MissCrispenCakes/CutiePI/README.md

# CutiePI

Two stuffed animals connected over the air. Hug one and the other bear's LED pulses with a red heartbeat. Hug both at the same time and they warm up too — like sending a hug through the mail.

Each bear contains an ESP32-S3, a force-sensitive resistor, a red LED, a small heating pad, and a temperature sensor for heater safety. Two builds are available depending on where the bears will live:

| Build | Board | How they talk | Range |
|---|---|---|---|
| `bear` (default) | Touch LCD 1.46B | ESP-NOW — direct peer-to-peer WiFi, no router | Same room / building |
| `bear-mqtt` | Touch LCD 1.46B | MQTT over internet via a shared broker | Anywhere in the world |
| `dualeye` *(coming soon)* | DualEye 1.28 | ESP-NOW | Same room / building |
| `dualeye-mqtt` *(coming soon)* | DualEye 1.28 | MQTT | Anywhere in the world |

The `dualeye` builds target the Waveshare ESP32-S3-DualEye-Touch-LCD-1.28 (dual 1.28" round displays, CH343P USB-UART chip). Pin assignments are stubbed in `firmware/include/config_dualeye.h` and must be verified against the schematic before those environments will compile.

---

## How It Works

| Who is hugging | What happens |
|---|---|
| Neither bear | Both bears are quiet |
| Bear A only | Bear B's LED pulses a red heartbeat |
| Bear B only | Bear A's LED pulses a red heartbeat |
| Both bears | Both LEDs pulse **and** both heating pads warm up |

The 1.46" round display shows a beating 8-bit heart animation at all times — a visual confirmation that the firmware booted and the power circuit is working, useful when testing on battery without a USB connection.

The firmware is identical on both bears — only `BEAR_ID` and network credentials differ.

---

## Repository Layout

```
CutiePI/
├── firmware/
│   ├── platformio.ini        # Build environments: bear/bear-mqtt (Touch 1.46B), dualeye/dualeye-mqtt (DualEye 1.28)
│   ├── include/
│   │   ├── config.h          # All pins, thresholds, BPM, safety limits, WiFi/MQTT credentials
│   │   └── config_dualeye.h  # DualEye 1.28 pin overrides (⚠ TBD — verify when boards arrive)
│   ├── src/
│   │   ├── main.cpp              # State machine + main loop
│   │   ├── comms.{h,cpp}         # ESP-NOW or MQTT — selected at build time
│   │   ├── sensors.{h,cpp}       # Pressure sensor reading + debounce
│   │   ├── heartbeat.{h,cpp}     # Lub-dub PWM LED animation
│   │   ├── actuators.{h,cpp}     # Heating pad control + temperature cycling + safety cutoff
│   │   ├── temp_sensor.{h,cpp}   # TMP36 analog temperature sensor read
│   │   ├── power_mgr.{h,cpp}     # Battery voltage + power button + board power latch
│   │   ├── display_mgr.{h,cpp}   # SPD2010 LCD + LVGL init; heart animation wrapper
│   │   └── (Display_SPD2010, LVGL_Driver, I2C_Driver, TCA9554PWR,
│   │      Touch_SPD2010, esp_lcd_spd2010, ui/SquareLine files)
│   │                             # Waveshare board SDK + SquareLine-exported UI assets
│   ├── boards/
│   │   ├── waveshare_esp32s3_touch_lcd_146b.json     # Current board
│   │   └── waveshare_esp32s3_dualeye_touch_lcd_128.json  # DualEye (boards incoming)
│   ├── fix/
│   │   ├── README.md                  # When and how to use these variants
│   │   ├── heartbeat_3x.cpp           # Arduino ESP32 3.x LEDC API
│   │   ├── comms_3x.cpp               # Arduino ESP32 3.x (ESP-NOW callback + full MQTT support)
│   │   ├── actuators_usb_heater.cpp   # P-channel MOSFET for USB heating pad
│   │   └── heartbeat_led_strip.cpp    # WS2812B addressable LED strip
│   ├── reference/             # Earlier standalone sketches kept for reference
│   └── snippets/              # Component test sketches — flash these before assembly
├── hardware/
│   ├── bom.md                 # Parts list, wiring diagram, and sensor selection guide
│   └── datasheets/            # Board schematics, pinouts, and component datasheets
└── docs/
    └── dev-logs/              # Build logs and development notes
```

---

## Hardware

Full parts list and wiring diagram: [`hardware/bom.md`](hardware/bom.md)

Quick overview per bear:

- **Waveshare ESP32-S3-Touch-LCD-1.46B** — microcontroller (ESP32-S3R8, 16 MB flash, 8 MB PSRAM, 1.46" round display)
- **FSR 402** (or similar) — force-sensitive resistor for hug detection
- **Red LED** + 100 Ω resistor — heartbeat glow
- **SparkFun Heating Pad 5×10 cm** + SparkFun MOSFET Power Controller — warmth; heater powered directly from LiPo via MOSFET board (not from the ESP32 header)
- **TMP36** analog temperature sensor — heater temperature safety
- **LiPo battery** (1S, 1500–2500 mAh, MX1.25 connector) — portable power, charges via the board's onboard USB-C circuit; Y-splitter feeds both the ESP32 and the MOSFET board

Default pin assignments (change in `config.h`):

| Signal | GPIO | Notes |
|---|---|---|
| Pressure sensor (ADC / touch) | 3 | ADC1_CH2 / touch T3 |
| LED (PWM) | 13 | LEDC PWM |
| Heater (MOSFET gate) | 12 | digital output |
| Temperature sensor (ADC) | 1 | ADC1_CH0 |

GPIO 6, 7, and 8 are reserved by the board's power management hardware (power button, power latch, battery ADC). See `hardware/bom.md` for the full reserved-pin table.

---

## Dependencies

Both Touch LCD builds require external libraries. PlatformIO downloads them automatically on the first `pio run` — no manual install needed:

| Library | Used by | Version | Note |
|---|---|---|---|
| `lvgl/lvgl` | `bear`, `bear-mqtt` | ^8.3.0 | ~80 MB download on first build; all subsequent builds work offline |
| `knolleary/PubSubClient` | `bear-mqtt` only | ^2.8 | |

Both builds also use these bundled APIs (no download needed):

| Header | Source |
|---|---|
| `Arduino.h` | Arduino framework (bundled with platform) |
| `WiFi.h` | ESP32 Arduino WiFi library (bundled with platform) |
| LEDC / ADC / Touch | ESP32 Arduino peripheral drivers (bundled with platform) |

The platform version is pinned to `espressif32 @ 6.5.0` in `platformio.ini`. After the first build, the ESP-NOW build works fully offline. MQTT requires internet at runtime to reach the broker.

---

## Coming from another setup?

If you're joining this project with existing hardware — for example a heating pad already wired to an Arduino Nano for interim testing — here's what changes:

- **Swap the Nano for a Waveshare ESP32-S3-Touch-LCD-1.46B.** The Arduino code won't port directly; use this repo instead.
- **The ESP32-S3 runs at 3.3 V.** You cannot drive a heating pad directly from a GPIO pin. You need the MOSFET circuit in `hardware/bom.md` — the same one your Nano demo likely uses, just wired to GPIO12 instead of whatever pin you had before.
- **Several GPIO pins are reserved by onboard hardware** (display, touch, IMU, speaker, mic, and power management). This project uses GPIO1 (TMP36 temp sensor), GPIO3 (pressure sensor), GPIO12 (heater), and GPIO13 (LED). GPIO6/7/8 are owned by the board's battery circuit. See the full reserved-pin table in `hardware/bom.md`.
- **PlatformIO replaces the Arduino IDE.** Install the VS Code extension, clone this repo, and `pio run` handles everything. You don't need to manually install board support or libraries.
- **Two bears need to know each other's MAC address** before they can communicate. Flash first with the placeholder config, grab the MAC from the serial monitor, then reflash with the real address. The README steps below walk through this.

Everything else — pressure sensor, LED, heating pad logic — works the same way you'd expect from Arduino. The full wiring diagram is in [`hardware/bom.md`](hardware/bom.md).

---

## Setup

### Prerequisites

- **PlatformIO** — pick whichever install method suits you:
  - VS Code extension (recommended): [marketplace.visualstudio.com/items?itemName=platformio.platformio-ide](https://marketplace.visualstudio.com/items?itemName=platformio.platformio-ide)
  - CLI only: [docs.platformio.org/en/latest/core/installation](https://docs.platformio.org/en/latest/core/installation/index.html)
- Two Waveshare ESP32-S3-Touch-LCD-1.46B boards
- Hardware assembled per `hardware/bom.md`

---

### Option A — ESP-NOW (same location)

#### Step 1 — Discover MAC addresses

Flash both boards with the default config (MACs left as `0xFF`) and open the serial monitor at 115200 baud. Each bear prints its MAC on boot:

```
This bear's MAC: AA:BB:CC:DD:EE:FF
```

Note both addresses.

#### Step 2 — Configure each bear

Open `firmware/include/config.h` and set:

```cpp
// Bear A
#define BEAR_ID 0
static const uint8_t PEER_MAC[6] = {0xAA, 0xBB, 0xCC, 0xDD, 0xEE, 0xFF}; // Bear B's MAC
```

```cpp
// Bear B
#define BEAR_ID 1
static const uint8_t PEER_MAC[6] = {0x11, 0x22, 0x33, 0x44, 0x55, 0x66}; // Bear A's MAC
```

#### Step 3 — Build and flash

From inside the `firmware/` folder:

```
pio run -e bear
pio run -e bear -t upload
```

**Upload port** — PlatformIO detects the port automatically. If it picks the wrong one, specify it manually:

| OS | Flag |
|----|---|
| Windows | `-t upload --upload-port COM11` (check Device Manager for your COM number) |
| macOS | `-t upload --upload-port /dev/cu.usbmodem*` |
| Linux | `-t upload --upload-port /dev/ttyACM0` |

#### Step 4 — Monitor serial output

```
pio device monitor
```

On boot the board prints its MAC address and battery voltage:
```
This bear's MAC: AA:BB:CC:DD:EE:FF
CutiePI Bear 0 ready! Battery: 3.94 V (78%)
```

If nothing appears, open the monitor first then press **RESET** on the board.

---

### Option B — MQTT (long distance)

#### Step 1 — Choose a broker

For testing, the free public broker `broker.hivemq.com` requires no account. For a permanent setup, consider a private broker (self-hosted Mosquitto, HiveMQ Cloud free tier, etc.).

#### Step 2 — Configure each bear

Create a local credentials file from the example (this file is gitignored — safe to put real values in):

**Windows:**
```powershell
copy firmware\include\secrets.h.example firmware\include\secrets.h
```

**macOS / Linux:**
```bash
cp firmware/include/secrets.h.example firmware/include/secrets.h
```

Edit `secrets.h` with your network and broker details:

```cpp
#define WIFI_SSID     "your_network_name"
#define WIFI_PASSWORD "your_network_password"
#define MQTT_BROKER   "broker.hivemq.com"  // or your own broker
#define MQTT_PORT     1883
#define MQTT_USER     ""  // leave empty for brokers that need no auth
#define MQTT_PASS     ""
```

Then set `BEAR_ID` in `firmware/include/config.h` (0 for Bear A, 1 for Bear B).

Each bear automatically publishes to `cutiepie/BEAR_ID/hug` and subscribes to the other bear's topic — no manual topic configuration needed.

#### Step 3 — Build and flash

```
pio run -e bear-mqtt
pio run -e bear-mqtt -t upload
```

#### Step 4 — Monitor serial output

```
pio device monitor
```

On boot the board prints its MAC address, battery voltage, and WiFi/MQTT connection status:
```
CutiePI Bear 0 ready! Battery: 3.94 V (78%)
```

If nothing appears, open the monitor first then press **RESET** on the board.

---

### Step 5 — Test before assembly (both options)

Use the component snippets in `firmware/snippets/` to verify each part before sewing anything up — especially the TMP36:

1. Flash `test_temp.cpp` with the TMP36 VOUT wired to GPIO1. Confirm it reads a plausible room temperature (~20–25 °C) and rises when you hold the sensor body. The serial output labels each reading against the 40/42/48 °C thresholds so you can verify the safety limits are reachable.
2. Flash `test_all.cpp` with everything connected. Hold the FSR and watch the heater cycle on and off as temperature crosses 40–42 °C.

Then flash the full firmware and confirm:
- Squeezing one bear's FSR makes the other bear's LED pulse
- Squeezing both FSRs simultaneously activates both LEDs and both heaters

Then sew everything inside the bears.

---

## Customization

All tunable parameters live in `firmware/include/config.h`:

| Parameter | Default | Effect |
|---|---|---|
| `PRESSURE_THRESHOLD` | `500` | ADC value (0–4095) that counts as a hug. Lower = more sensitive. |
| `PRESSURE_DEBOUNCE_MS` | `200` | Milliseconds before a press/release is registered. |
| `HEARTBEAT_BPM` | `70` | Speed of the LED heartbeat animation. |
| `HEATER_MAX_ON_MS` | `300000` (5 min) | Session time cutoff — backup if temp sensor disconnects. |
| `TEMP_MAX_SAFE_C` | `48.0` | Hard over-temperature shutoff. Re-hug to re-enable. |
| `TEMP_TARGET_C` | `42.0` | Comfort temperature target; heater cycles off here. |
| `TEMP_HYSTERESIS_C` | `2.0` | Heater cycles back on below `TARGET − HYSTERESIS` (40 °C default). |

---

## Roadmap

- **Captive portal setup** — on first boot (or when PEER_MAC is still placeholder), the bear starts a temporary WiFi access point. Connect on your phone and a simple webpage shows the MAC address, current config, and connection status. Eliminates the need to open a serial monitor during setup.

---

## Safety

### Heater safety — three independent layers

| Layer | Mechanism | Default |
|---|---|---|
| **Temperature cycling** | Heater turns off at `TEMP_TARGET_C`, back on below `TEMP_TARGET_C − TEMP_HYSTERESIS_C` | 42 °C target, 40 °C lower band |
| **Over-temperature cutoff** | Hard shutoff above `TEMP_MAX_SAFE_C`; re-hug to re-enable | 48 °C |
| **Session time cutoff** | Hard shutoff after `HEATER_MAX_ON_MS` regardless of temperature; re-hug to re-enable. Acts as a backup if the temperature sensor is disconnected or fails | 5 min |

All three are enforced inside `actuators_update()`, called every `loop()`. Releasing a hug always turns the heater off immediately regardless of temperature.

### Hardware requirements

- The SparkFun Heating Pad 5×10 cm is rated 5 V / ~750 mA (~6.5 Ω). Running it directly from LiPo (~3.7 V) draws ~570 mA — well within the SparkFun MOSFET board's 6.5 A rating. An optional boost converter (Adafruit MiniBoost #4654) raises this to 5.2 V / ~800 mA for more warmth at the cost of battery runtime. See `hardware/bom.md` for both wiring options.
- Mount the TMP36 **against the heating pad surface**, not floating in stuffing — it needs to read pad temperature, not air temperature.
- Use heat-resistant material between the heating pad and stuffing to prevent hot spots.
- Never leave the bears unattended while charging.
