MissCrispenCakes/CutiePI/firmware/build_log.md

# Build Log

## 2026-04-20 — Both environments passing

Platform: `espressif32 @ 6.5.0` (framework-arduinoespressif32 @ 2.0.14)
Hardware: ESP32-S3 DevKitC-1-N8 (8 MB QD, No PSRAM) — 240 MHz, 320 KB RAM, 8 MB Flash

| Environment | Status  | Duration | RAM used | Flash used |
|---|---|---|---|---|
| `bear` | SUCCESS | 3.09s | 13.4% (44068 B / 327680 B) | 21.1% (705241 B / 3342336 B) |
| `bear-mqtt` | SUCCESS | 3.33s | 13.9% (45428 B / 327680 B) | 21.6% (721897 B / 3342336 B) |

### Dependency graph

**bear** (ESP-NOW):
- WiFi @ 2.0.0

**bear-mqtt** (MQTT):
- PubSubClient @ 2.8.0
- WiFi @ 2.0.0

### Notes
- No warnings in project source files. One upstream framework warning in `esp32-hal-uart.c` (unrelated to this project).
- MQTT build adds ~1360 B RAM and ~16656 B Flash over the ESP-NOW build — both well within budget.
