MissCrispenCakes/CutiePI/firmware/include/config.h

#pragma once

// ── Device Identity ───────────────────────────────────────────────────────────
// Set BEAR_ID to 0 for Bear A, 1 for Bear B before flashing each device.
// Run once with Serial.println(WiFi.macAddress()) in setup() to discover MACs.
#define BEAR_ID 0

// ── Peer MAC Address (ESP-NOW mode only) ──────────────────────────────────────
// Not used in MQTT mode — skip this section if building with USE_MQTT.
// REQUIRED for ESP-NOW: replace with the actual MAC of the OTHER bear.
// To find the MAC: flash with BEAR_ID set, open Serial Monitor — it prints on boot.
// All-0xFF is the ESP-NOW broadcast address and will NOT reach a specific peer.
#ifndef USE_MQTT
  #if BEAR_ID == 0
  static const uint8_t PEER_MAC[6] = {0xFF, 0xFF, 0xFF, 0xFF, 0xFF, 0xFF}; // ← Bear B MAC here
  #else
  static const uint8_t PEER_MAC[6] = {0xFF, 0xFF, 0xFF, 0xFF, 0xFF, 0xFF}; // ← Bear A MAC here
  #endif
#endif

// ── WiFi + MQTT (MQTT mode only) ──────────────────────────────────────────────
// Only used when building with USE_MQTT (pio run -e bear-mqtt).
// Credentials live in secrets.h (gitignored) — never hardcode them here.
// Copy firmware/include/secrets.h.example → firmware/include/secrets.h first.
#ifdef USE_MQTT
  #if __has_include("secrets.h")
    #include "secrets.h"
  #endif
  // Fallback placeholders — active only if secrets.h is missing.
  #ifndef WIFI_SSID
    #define WIFI_SSID     "your_network_name"
    #define WIFI_PASSWORD "your_network_password"
    #define MQTT_BROKER   "broker.hivemq.com"
    #define MQTT_PORT     1883
    #define MQTT_USER     ""
    #define MQTT_PASS     ""
  #endif
#endif

// ── Sensor Mode ───────────────────────────────────────────────────────────────
// By default the hug sensor is an FSR (Force-Sensitive Resistor) read via ADC.
// Uncomment the line below to switch to the ESP32-S3 capacitive touch pad instead.
// Read the "Sensor Selection" section in hardware/bom.md before choosing —
// there is a known WiFi/touch interference issue that affects this project.
// #define USE_TOUCH_SENSOR

// ── Board-specific pin overrides ─────────────────────────────────────────────
// DualEye 1.28 has different reserved pins; GPIO1 is the board's BAT_ADC and unavailable for TMP36.
// Pin definitions for that board live in config_dualeye.h and are pulled in below.
// Everything else in this file (thresholds, BPM, timing) applies to both boards.
#ifdef BOARD_DUALEYE
  #include "config_dualeye.h"
#endif

// ── Temperature Sensor ────────────────────────────────────────────────────────
// TMP36 analog temperature sensor — no voltage divider or library needed.
// Wiring: 3.3 V → TMP36 pin 1 (VS) | GPIO1 → TMP36 pin 2 (VOUT) | GND → TMP36 pin 3
// NOTE: GPIO1 is used here for Touch LCD 1.46B only.
//       On DualEye 1.28, GPIO1 is the battery ADC — see config_dualeye.h.
#ifndef BOARD_DUALEYE
#define PIN_TEMP_SENSOR       1   // ADC1_CH0 — Touch LCD 1.46B only
#endif

// Safety thresholds (°C). See hardware/bom.md for TMP36 wiring.
#define TEMP_MAX_SAFE_C       48.0f  // hard shutoff; re-hug to re-enable
#define TEMP_TARGET_C         42.0f  // heater cycles off at this temperature
#define TEMP_HYSTERESIS_C      2.0f  // heater cycles back on below (TARGET − HYSTERESIS)

// ── Pin Definitions ───────────────────────────────────────────────────────────
// Waveshare ESP32-S3-Touch-LCD-1.46B pin constraints:
//   GPIO4  = TP_INT (touch panel interrupt)       ← do not use
//   GPIO5  = LCD_BL  (display backlight)          ← do not use
//   GPIO6  = PWR_KEY_Input_PIN (power button)     ← reserved — see power_mgr.cpp
//   GPIO7  = PWR_Control_PIN  (power latch)       ← reserved — see power_mgr.cpp
//   GPIO8  = BAT_ADC_PIN      (battery ADC)       ← reserved — see power_mgr.cpp
// External header free GPIO: GPIO1, GPIO3, GPIO12, GPIO13
// (DualEye 1.28 pin constraints: see config_dualeye.h)
#ifndef BOARD_DUALEYE
#define PIN_PRESSURE_SENSOR   3   // ADC input (FSR mode, ADC1_CH2) or touch pad T3 (touch mode)
#define PIN_LED               13  // PWM output — red LED (via current-limiting resistor)
#define PIN_HEATER            12  // Digital output — MOSFET gate controlling heating pad
#endif

// ── Sensor Thresholds ─────────────────────────────────────────────────────────
// FSR mode: ADC value (0–4095) above which a hug is detected.
#define PRESSURE_THRESHOLD    500

// Touch mode: touch fires when a reading drops below (baseline × ratio).
// 0.6 = requires a 40% drop from the untouched baseline. Raise toward 0.8 if
// the bear is hard to trigger through thick fabric; lower toward 0.4 to reduce
// false triggers from nearby hands without contact.
// Note: GPIO3 = touch channel T3 on the ESP32-S3.
#define TOUCH_THRESHOLD_RATIO 0.6f

// Debounce applies to both modes. Touch is noisier due to WiFi interference —
// if using USE_TOUCH_SENSOR, consider raising this to 500.
#define PRESSURE_DEBOUNCE_MS  200

// ── Heartbeat Parameters ──────────────────────────────────────────────────────
#define HEARTBEAT_BPM         70   // Beats per minute for LED animation

// ── Heater Safety ─────────────────────────────────────────────────────────────
#define HEATER_MAX_ON_MS      (5 * 60 * 1000UL)  // Hard cutoff after 5 min; UL prevents overflow on 16-bit int targets

// ── Compile-time Sanity Checks ────────────────────────────────────────────────
#if BEAR_ID != 0 && BEAR_ID != 1
  #error "BEAR_ID must be 0 (Bear A) or 1 (Bear B)"
#endif
#if PRESSURE_THRESHOLD < 1 || PRESSURE_THRESHOLD > 4094
  #error "PRESSURE_THRESHOLD must be between 1 and 4094 (12-bit ADC range is 0–4095)"
#endif
