MissCrispenCakes/CutiePI/(commit log)

2026-04-20 heating pad proof of functioning test code
2026-04-20 Add MQTT long-distance build, touch sensor mode, secrets, and variant reference files
2026-04-20 Update temperature sensor safety information in README
2026-04-25 Update TIP120 instead of n-channel MOSFET IRLZ44.txt
2026-04-25 Add pinout documentation for ESP32 eyeball board
    Documented the pinout layout for the ESP32 eyeball board, including power and GPIO functions.
2026-04-25 Update testing notes for TIP120 and ESP32 pinout
    Updated testing notes to reflect the use of TIP120 instead of IRLZ44N and included a link for heatsink information. Adjusted pin configuration for temperature sensor shut-off code to match ESP32 pinout.
2026-04-25 Revise hardware notes for TIP120 and sensor updates
    Updated notes to reflect the use of TIP120 instead of IRLZ44N and included a link to an analog temperature sensor. Mentioned the use of Nano Arduino in place of ESP32-S3 and the need to adjust pin configurations.
2026-04-25 Document upload error for ESP32-S3 firmware
    The upload process failed due to the specified port '/dev/ttyUSB0' not existing. This error occurred during the attempt to upload the firmware to the ESP32-S3-DevKitC-1.
2026-04-25 Updated builds for esp32-s3 touch lcd + missing boards config
    [power_mgr.cpp, power_mgr.h, temp_sensor.cpp, temp_sensor.h, test_temp.cpp]
2026-04-25 v0.2 — TMP36 sensor, power management, Waveshare 1.46B board support
    - Add power_mgr module: GPIO7 power latch, GPIO6 button, GPIO8 battery ADC
    - Switch temp sensor from KY-013 NTC thermistor to TMP36 (no voltage divider needed)
    - Fix boards_dir missing from platformio.ini (custom board was never loading)
    - Fix extra_flags array format in custom board JSON; add ARDUINO_USB_MODE=1
    - Reassign all GPIO pins away from board-reserved power management lines:
    pressure sensor 8->3, LED 7->13, heater 6->12
    - Update all snippets, fix/ variants, bom.md, README, and gitignore
    [actuators.cpp, actuators.h, actuators_usb_heater.cpp, config.h, heartbeat_led_strip.cpp, main.cpp, test_all.cpp]
2026-04-25 Document device monitor usage steps
    Added notes for using the device monitor in firmware.
2026-04-25 Add delay in setup for sensor initialization
2026-04-25 Update device monitor notes with status and battery info
    Added device status updates and battery information.
2026-04-25 clean main.cpp and add monitor control so platformio behaves like arduino ide
2026-04-25 Reorganise repo structure
    - docs/dev-logs/ ← build logs and dev notes (were at root and firmware/)
    - hardware/datasheets/ ← board schematics, pinouts, PDFs (were loose in hardware/)
    - firmware/reference/ ← earlier standalone sketches kept for reference
    - firmware/fix/ restored from accidental rename to codefix/
    - README updated with new directory tree
    [sketch_apr20b_heating_pad_with_temp_autoshutoff_hugbears.ino]
2026-04-25 Fix BOM: remove separate TP4056, add battery and heater warnings
    - Remove separate TP4056 charger — board charges via USB-C onboard
    - Add JST polarity warning before connecting LiPo
    - Flag 5V pin uncertainty (VBUS vs boost converter) with multimeter
    check step and fallback options if pin is VBUS-only
    - Add battery-vs-USB boot procedure table
    - Note that serial monitor requires USB (USB CDC, no UART chip)
2026-04-25 Fix GPIO6 error in USB heater variant, clean up legacy references
    - actuators_usb_heater.cpp: P-MOSFET gate was incorrectly wired to
    GPIO6 (power button) — corrected to GPIO12
    - README: replace 'thermistor' with 'temperature sensor' in safety table
    - reference sketch: add header noting it is legacy Arduino Nano code,
    not ESP32-S3 pin assignments
    [actuators_usb_heater.cpp, sketch_apr20b_heating_pad_with_temp_autoshutoff_hugbears.ino]
2026-04-25 Add DualEye 1.28 build environment (stub, boards incoming)
    - New board JSON for Waveshare ESP32-S3-DualEye-Touch-LCD-1.28
    (CH343P USB-UART, no USB CDC flag needed)
    - platformio.ini: add dualeye / dualeye-mqtt environments; move
    -DARDUINO_USB_CDC_ON_BOOT=1 out of shared [env] into bear/bear-mqtt
    only — DualEye must not inherit it
    - config_dualeye.h: pin override stub with documented conflicts
    (GPIO1=BAT_ADC, GPIO6/7=I2C) and compile-time error gate until
    pins are verified with schematic
    - config.h: include config_dualeye.h under BOARD_DUALEYE guard
    - power_mgr.cpp: ifdef out power-latch logic for DualEye (no latch
    circuit available); battery ADC formula identical, just GPIO1 vs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
    [config.h, config_dualeye.h, power_mgr.cpp]
2026-04-25 Add boot backlight flash to confirm board alive on battery
    3x blink of the LCD backlight in setup() gives visual confirmation
    the board has booted without needing USB serial.
2026-04-25 added battery powerup featres and instructions - screen should flash 3x if LiPo power connection working as expected
2026-04-25 Documentation audit fixes
    - README: remove stale TP4056 reference from hardware list
    - README: add MQTT_USER/MQTT_PASS to MQTT secrets example
    - README: add Step 4 serial monitor instructions to Option B (MQTT)
    to match Option A; shared assembly test renumbered Step 5
    - config.h: clarify GPIO1 BAT_ADC wording (was 'conflict')
    - bom.md: update battery boot table to describe 3-flash indicator
    and add boot troubleshooting notes
    [config.h]
2026-04-25 bom.md: expand JST polarity check with multimeter steps and fix instructions
2026-04-25 another update to battery check file
2026-04-28 BOM hardware revision: MOSFET board, correct connectors, real part specs
    - Replace discrete MOSFET + gate resistor + flyback diode with SparkFun
    MOSFET Power Controller (FDS6630A, logic-level, built-in pull-down/diode)
    - Fix battery connector throughout: JST-PH → MX1.25 (both Waveshare boards)
    - Add MX1.25 Y-splitter cable: LiPo splits to ESP32 port and MOSFET board
    - Heater now powered at LiPo voltage via MOSFET board, not ESP32 5V pin;
    removes unresolvable VBUS-vs-boost-converter uncertainty entirely
    - Correct heater current: was ≤500mA, actual SparkFun pad is ~750mA at 5V
    (~570mA at 3.7V LiPo direct)
    - Add optional components section: boost converter, capacitor, polyfuse,
    heat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
2026-04-28 Update BOM boost section to Adafruit MiniBoost 5V @ 1A (#4654)
    Replace generic MT3608 reference with the specific MiniBoost board on hand.
    Correct output voltage to 5.2V, heater draw to ~800mA, efficiency to ~78%
    at full load, and recalculate battery runtime to ~1.6h on 1500mAh.
    Add EN pin wiring option so boost shuts down when heater is idle.
    Polyfuse corrected from 750mA to 800mA to match actual load.
2026-04-28 Add SPD2010 display driver and LVGL heart animation to bear firmware
    Ports the SquareLine-generated heartbeat animation from the reference sketch
    into the main PlatformIO project. The 8-bit heart pulses on the 412x412 LCD
    at boot, giving visible confirmation that firmware loaded and power management
    is working — no serial monitor or USB connection required.
    Changes:
    - firmware/src/: Waveshare board SDK files (SPD2010 QSPI driver, LVGL glue,
    I2C, TCA9554 GPIO expander, SPD2010 touch driver) + SquareLine UI files
    (heart image, animation definitions, screen layout)
    - Display_SPD2010.cpp: backlight uses Arduino 2.x LEDC API (ledcSetup/
    ledcAttachPin) to match espressif32@6.5.0; LVGL dra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
2026-04-28 Fix README: LVGL dependency, heater spec, display description, repo layout
    - Dependencies: add lvgl/lvgl ^8.3.0 with ~80 MB first-build note; correct
    the claim that bear/bear-mqtt have no external libraries
    - Safety section: replace wrong '≤500 mA' heater spec with accurate 750 mA
    rated / 570 mA at LiPo, with boost option reference
    - How It Works: add one-line description of the heart animation on the display
    - Repo layout: add display_mgr and Waveshare SDK files to src listing
